SchiopuAndreiViorel/360-VideoBooth/Proiect 360VideoBooth/Imagini asamblare Finala/asamblare_5_vedere.jpeg

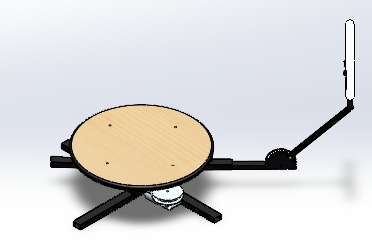
Proiect 360VideoBooth/Imagini asamblare Finala/asamblare_5_vedere.jpeg
