SchiopuAndreiViorel/360-VideoBooth/Proiect 360VideoBooth/SolidWorks/Untitled3.JPG

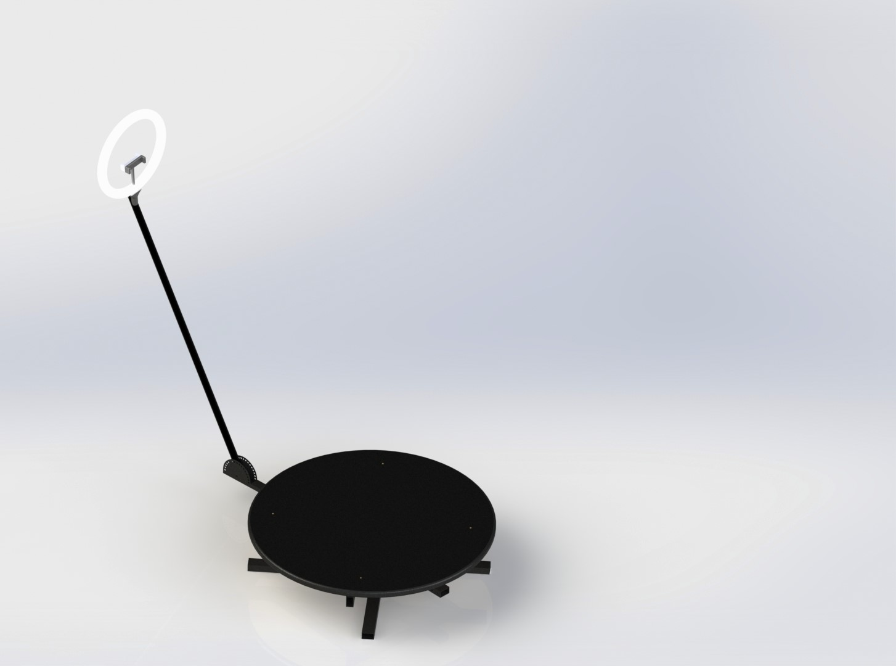
Proiect 360VideoBooth/SolidWorks/Untitled3.JPG
