SchiopuAndreiViorel/360-VideoBooth/Proiect 360VideoBooth/Simulare Cod+Parte electrica/link proiect thinkercad.txt

https://www.tinkercad.com/things/kW6MDn676y3-tinkercad-circuit-proiect
