SchiopuAndreiViorel/360-VideoBooth/Proiect 360VideoBooth/Imagini asamblare Finala/ansamblu_general.JPG

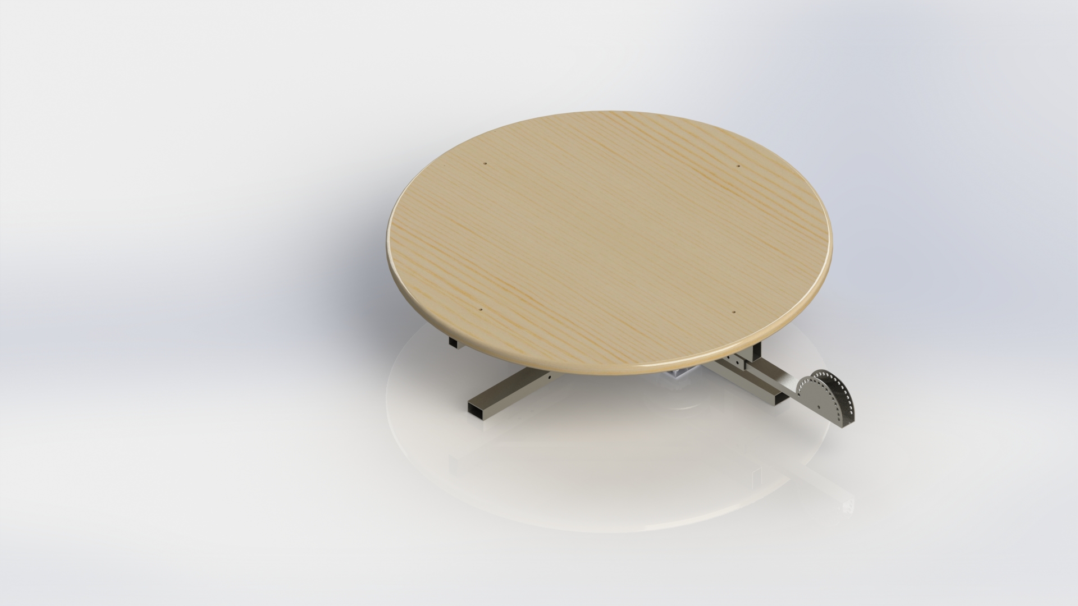
Proiect 360VideoBooth/Imagini asamblare Finala/ansamblu_general.JPG
