SchiopuAndreiViorel/360-VideoBooth/Proiect 360VideoBooth/Imagini asamblare Finala/DC-Motor.JPG

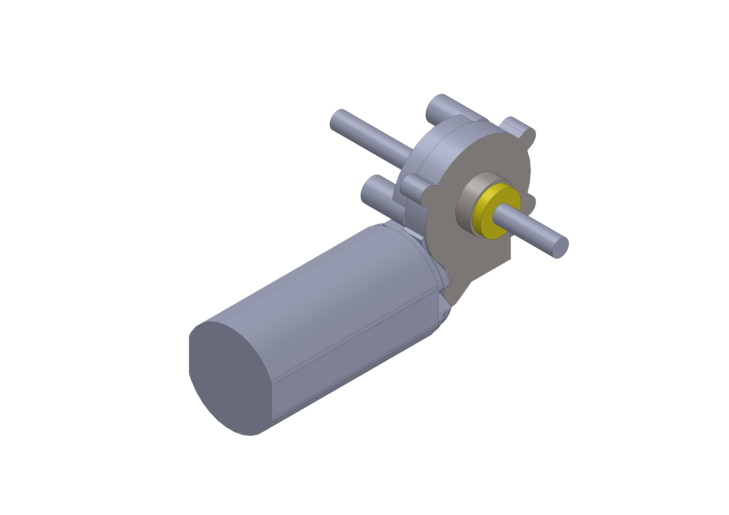
Proiect 360VideoBooth/Imagini asamblare Finala/DC-Motor.JPG
