SchiopuAndreiViorel/360-VideoBooth/Proiect 360VideoBooth/SolidWorks/Assem down - Copy.SLDASM

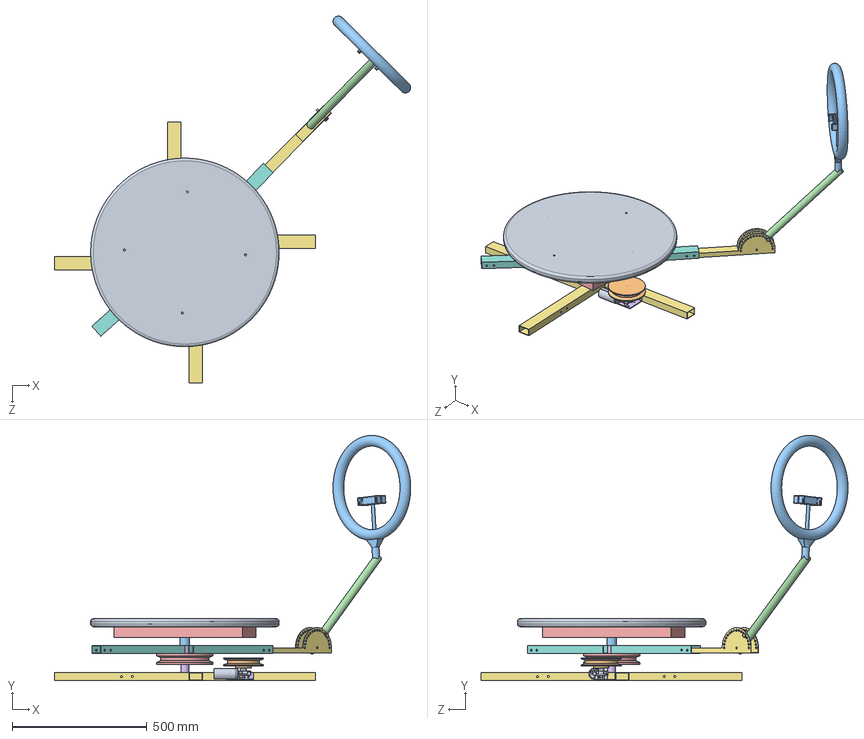
[picture p12: CAD file, 2026-05-26]
Proiect 360VideoBooth/SolidWorks/Assem down - Copy.SLDASM
1323.7 x 910.7 x 1362.8 mm
pulley
bearing x 2
pulley2
plate
holder 1 x 2
rod
ring light
siguranta
VALEO-NIDEC DC 24V Motor
