SchiopuAndreiViorel/360-VideoBooth/Proiect 360VideoBooth/SolidWorks/Assem top - Copy.SLDASM

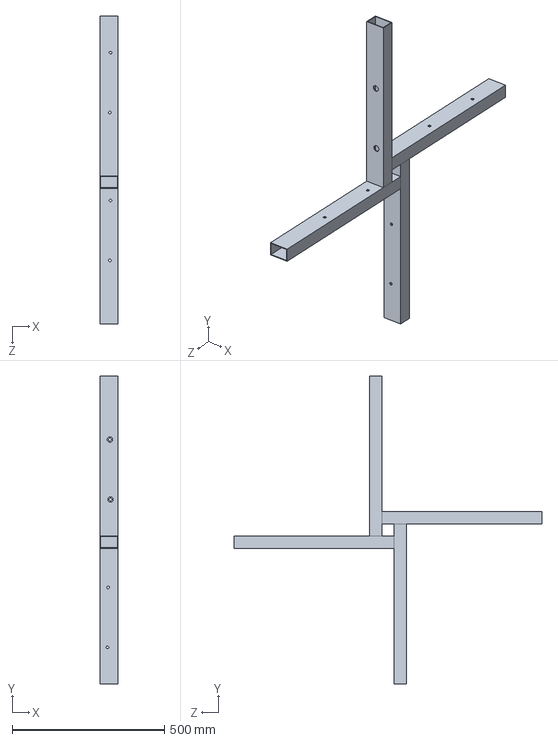
[picture p13: CAD file, 2026-05-26]
Proiect 360VideoBooth/SolidWorks/Assem top - Copy.SLDASM
60.0 x 1010.0 x 1010.0 mm
