SchiopuAndreiViorel/360-VideoBooth/Proiect 360VideoBooth/SolidWorks/holder 1.SLDPRT

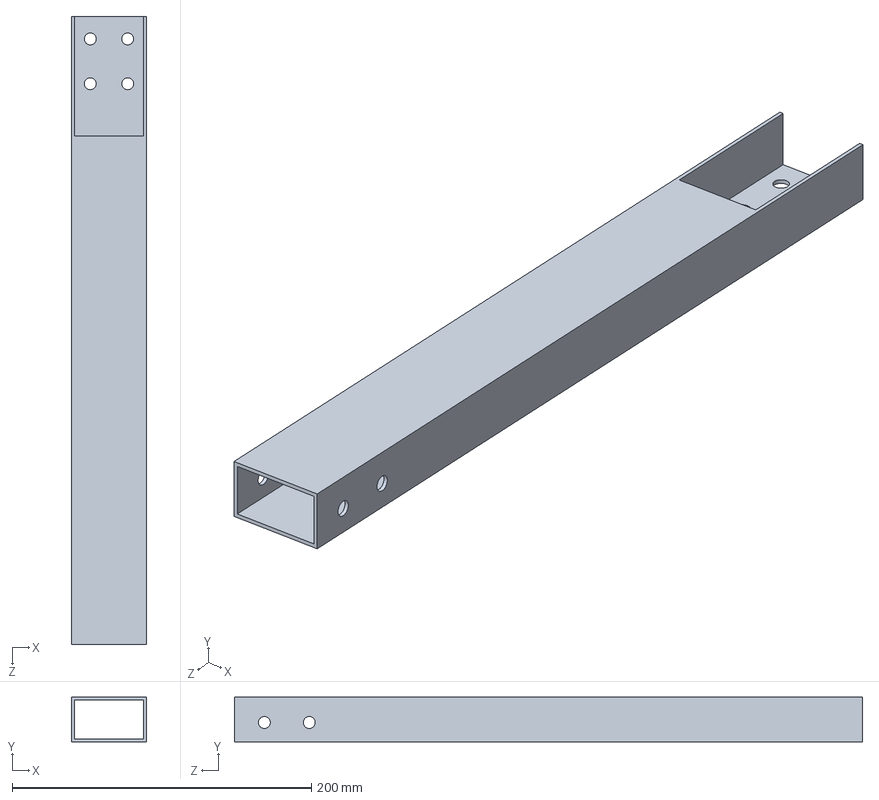
[picture p14: CAD file, 2026-05-26]
Proiect 360VideoBooth/SolidWorks/holder 1.SLDPRT
50.0 x 30.0 x 420.0 mm
