SchiopuAndreiViorel/360-VideoBooth/Proiect 360VideoBooth/SolidWorks/siguranta.SLDPRT

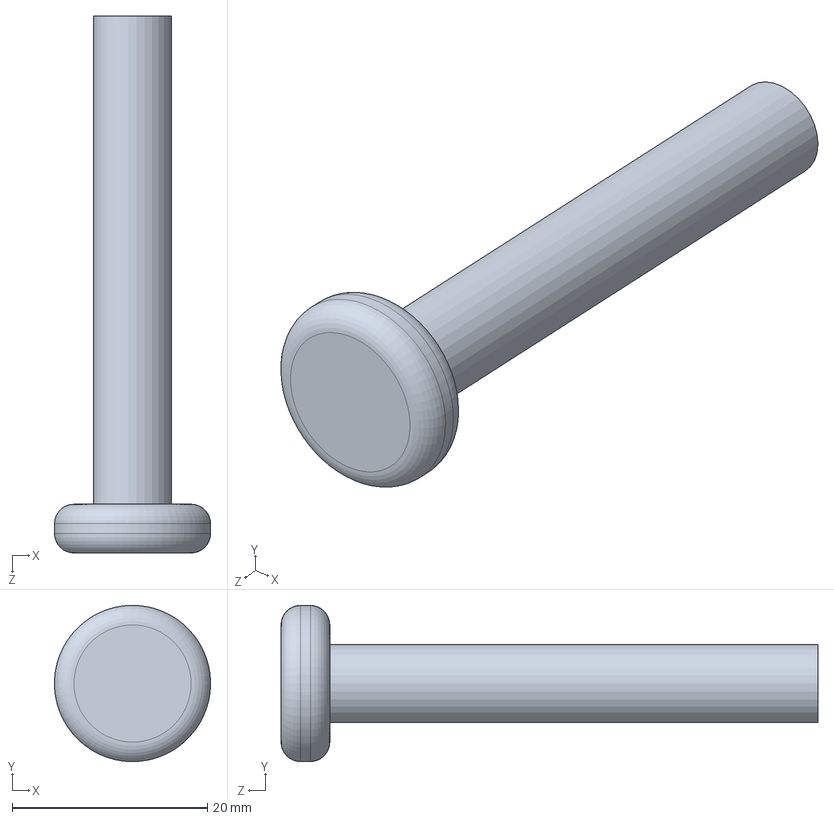
[picture p15: CAD file, 2026-05-26]
Proiect 360VideoBooth/SolidWorks/siguranta.SLDPRT
16.0 x 16.0 x 55.0 mm
