SchiopuAndreiViorel/360-VideoBooth/Proiect 360VideoBooth/SolidWorks/rod.SLDPRT

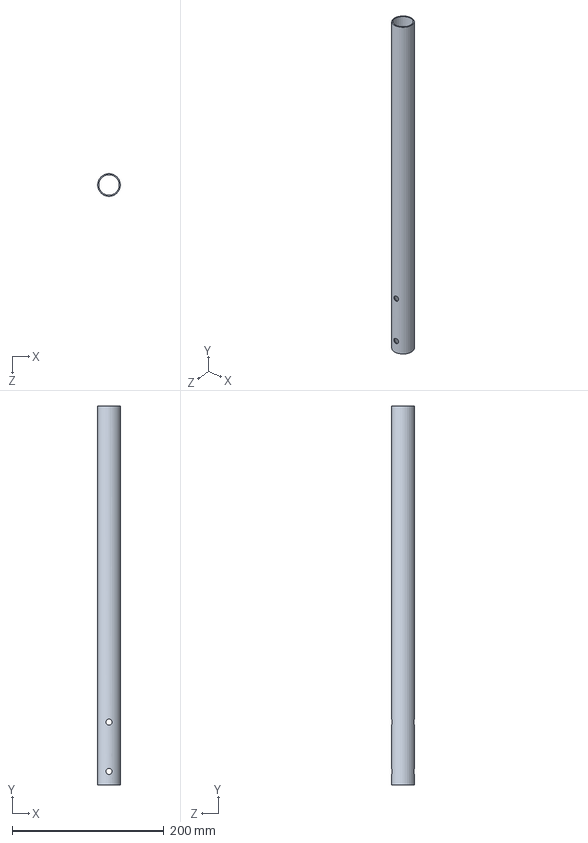
[picture p16: CAD file, 2026-05-26]
Proiect 360VideoBooth/SolidWorks/rod.SLDPRT
30.0 x 500.0 x 30.0 mm
