SchiopuAndreiViorel/360-VideoBooth/Proiect 360VideoBooth/SolidWorks/Part1.SLDPRT

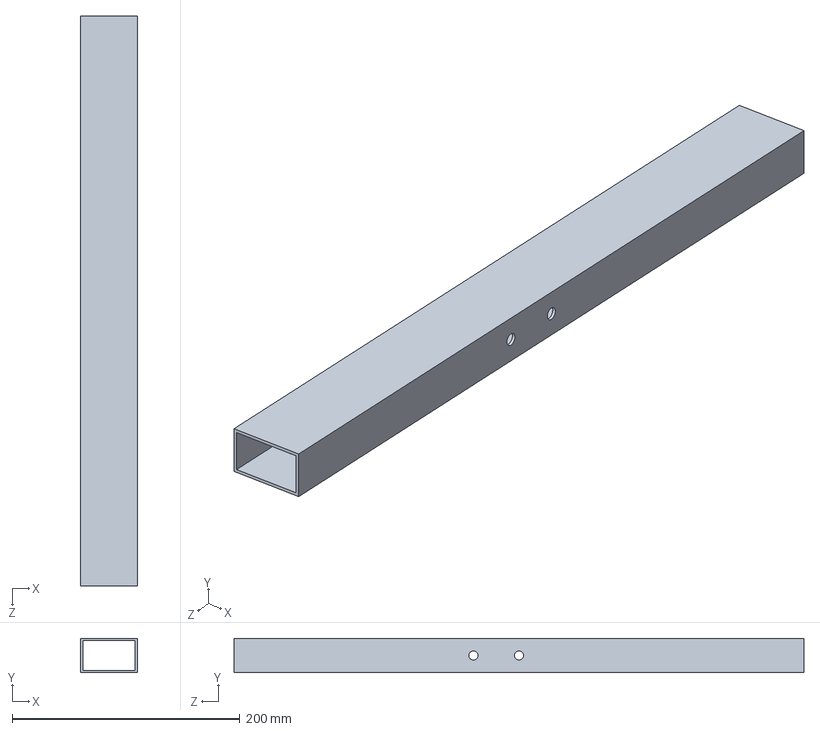
[picture p17: CAD file, 2026-05-26]
Proiect 360VideoBooth/SolidWorks/Part1.SLDPRT
50.0 x 30.0 x 500.0 mm
