SchiopuAndreiViorel/360-VideoBooth/Proiect 360VideoBooth/SolidWorks/Part5.SLDPRT

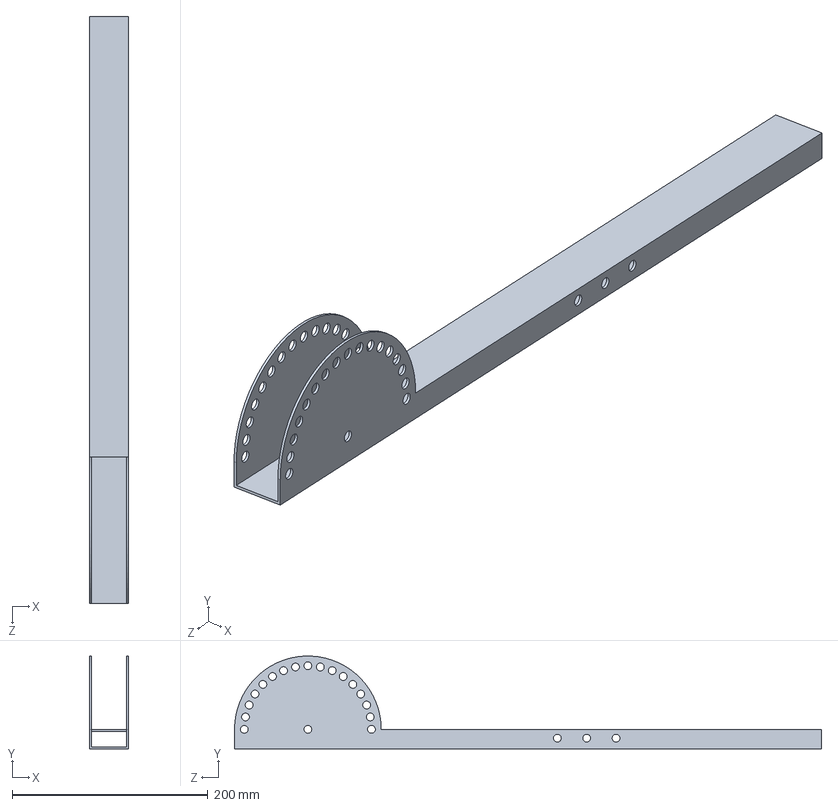
[picture p18: CAD file, 2026-05-26]
Proiect 360VideoBooth/SolidWorks/Part5.SLDPRT
40.0 x 94.9 x 600.0 mm
