SchiopuAndreiViorel/360-VideoBooth/Proiect 360VideoBooth/SolidWorks/pulley.SLDPRT

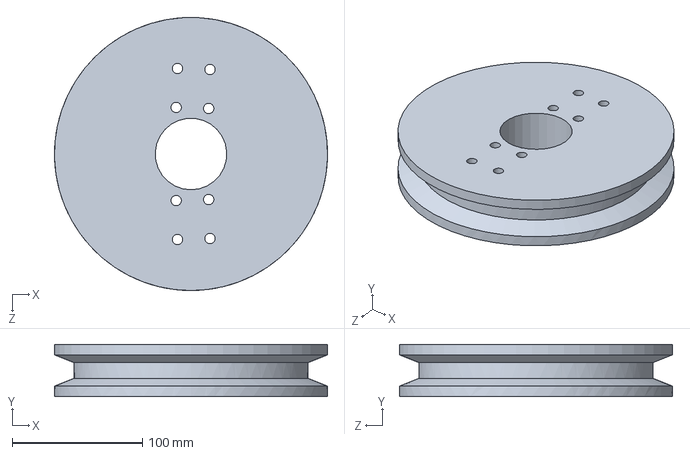
[picture p19: CAD file, 2026-05-26]
Proiect 360VideoBooth/SolidWorks/pulley.SLDPRT
209.9 x 40.0 x 210.0 mm
