SchiopuAndreiViorel/360-VideoBooth/Proiect 360VideoBooth/SolidWorks/Part7.SLDPRT

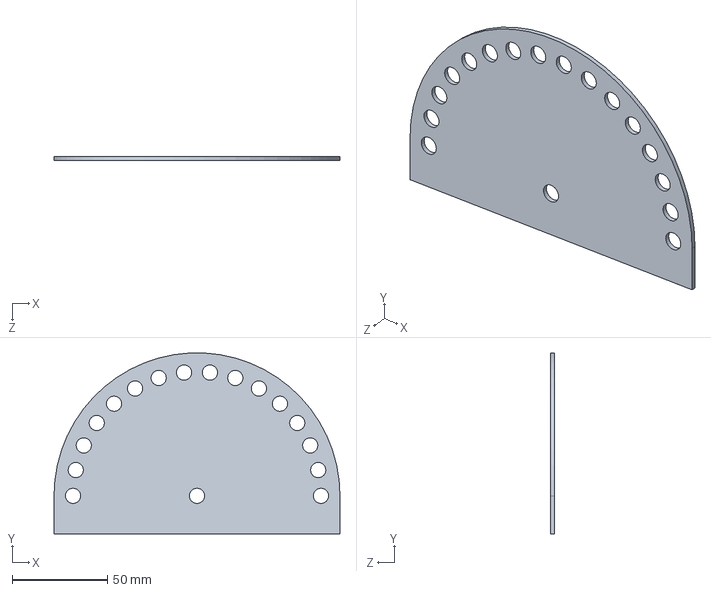
[picture p20: CAD file, 2026-05-26]
Proiect 360VideoBooth/SolidWorks/Part7.SLDPRT
150.0 x 94.9 x 2.00 mm
