SchiopuAndreiViorel/360-VideoBooth/Proiect 360VideoBooth/SolidWorks/Part2.SLDPRT

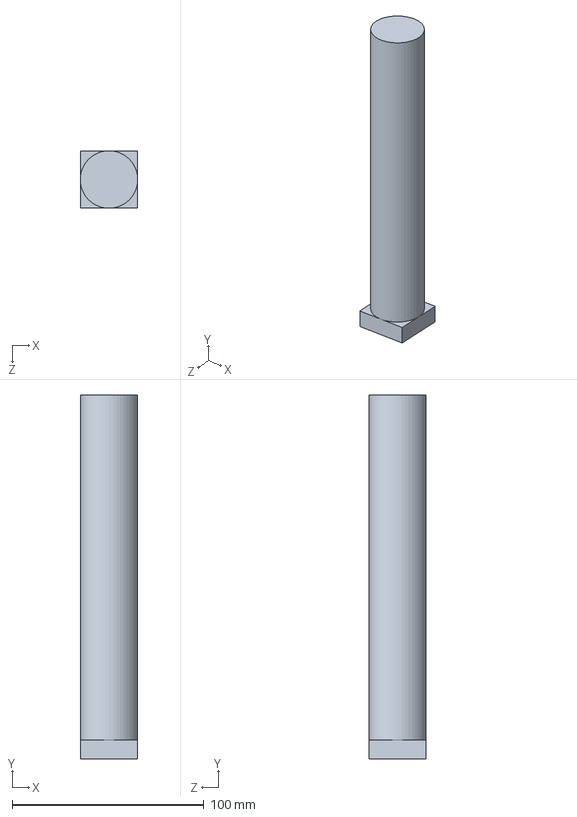
[picture p21: CAD file, 2026-05-26]
Proiect 360VideoBooth/SolidWorks/Part2.SLDPRT
30.0 x 190.0 x 30.0 mm
