SchiopuAndreiViorel/360-VideoBooth/Proiect 360VideoBooth/SolidWorks/pulley2.SLDPRT

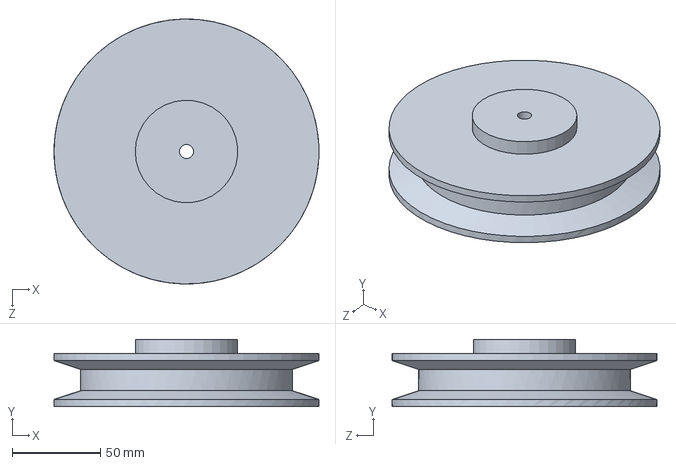
[picture p22: CAD file, 2026-05-26]
Proiect 360VideoBooth/SolidWorks/pulley2.SLDPRT
150.0 x 38.0 x 149.9 mm
