SchiopuAndreiViorel/360-VideoBooth/Proiect 360VideoBooth/SolidWorks/half circle.DXF

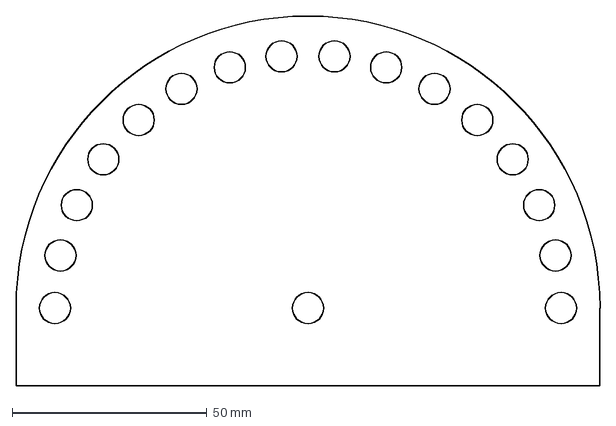
[picture p23: CAD file, 2026-05-26]
Proiect 360VideoBooth/SolidWorks/half circle.DXF
150.0 x 95.0 mm
