SchiopuAndreiViorel/360-VideoBooth/Proiect 360VideoBooth/SolidWorks/ring light.SLDPRT

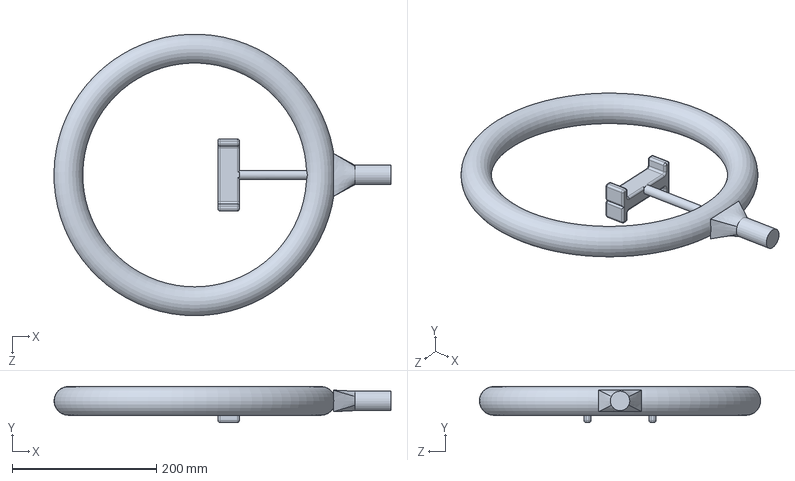
[picture p24: CAD file, 2026-05-26]
Proiect 360VideoBooth/SolidWorks/ring light.SLDPRT
467.0 x 50.0 x 389.8 mm
