SchiopuAndreiViorel/360-VideoBooth/Proiect 360VideoBooth/SolidWorks/Flat pattern - new.DXF

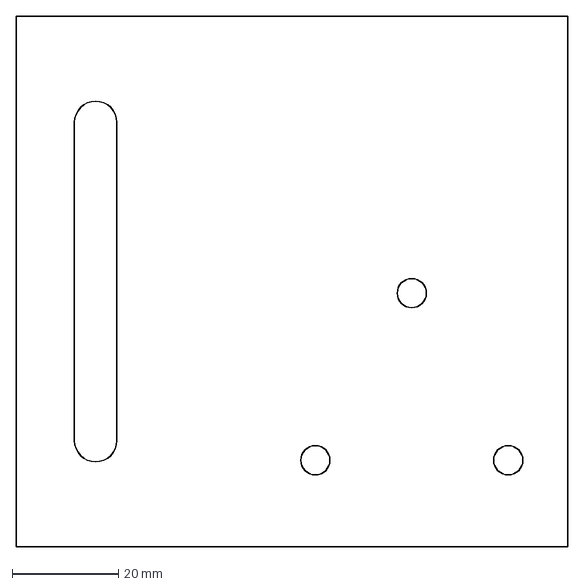
[picture p25: CAD file, 2026-05-26]
Proiect 360VideoBooth/SolidWorks/Flat pattern - new.DXF
104.0 x 100.0 mm
