SchiopuAndreiViorel/360-VideoBooth/Proiect 360VideoBooth/SolidWorks/plate.SLDPRT

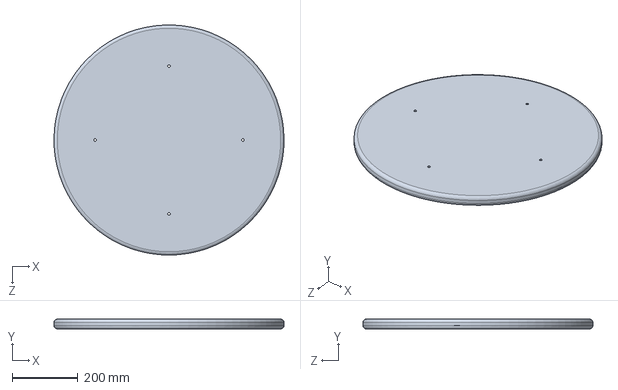
[picture p26: CAD file, 2026-05-26]
Proiect 360VideoBooth/SolidWorks/plate.SLDPRT
699.8 x 30.0 x 700.0 mm
