SchiopuAndreiViorel/360-VideoBooth/Proiect 360VideoBooth/SolidWorks/Part11.SLDPRT

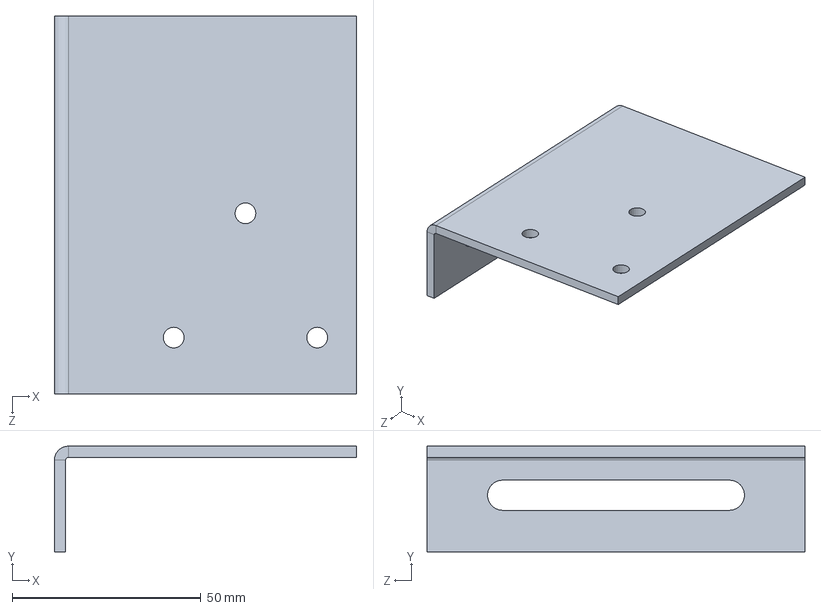
[picture p27: CAD file, 2026-05-26]
Proiect 360VideoBooth/SolidWorks/Part11.SLDPRT
80.0 x 28.0 x 100.0 mm
