SchiopuAndreiViorel/360-VideoBooth/Proiect 360VideoBooth/SolidWorks/Part4.SLDPRT

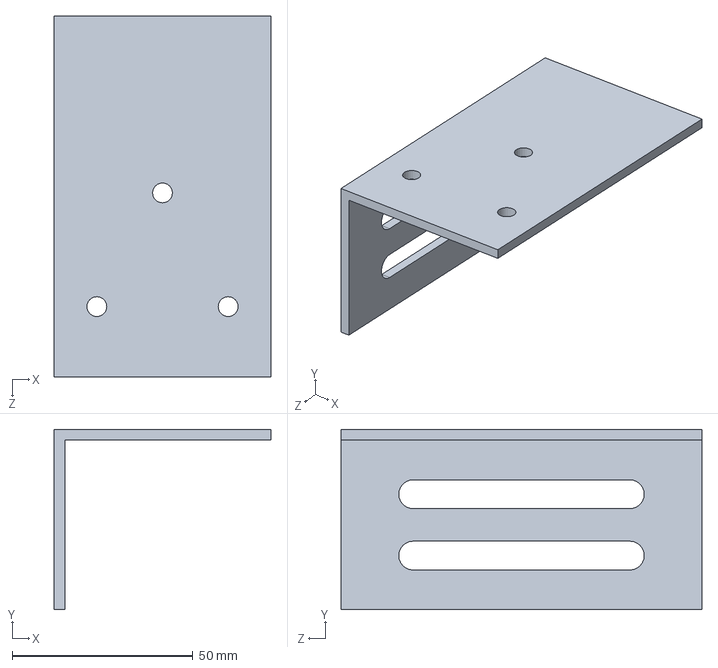
[picture p28: CAD file, 2026-05-26]
Proiect 360VideoBooth/SolidWorks/Part4.SLDPRT
60.0 x 50.0 x 100.0 mm
