SchiopuAndreiViorel/360-VideoBooth/Proiect 360VideoBooth/SolidWorks/bearing.SLDPRT

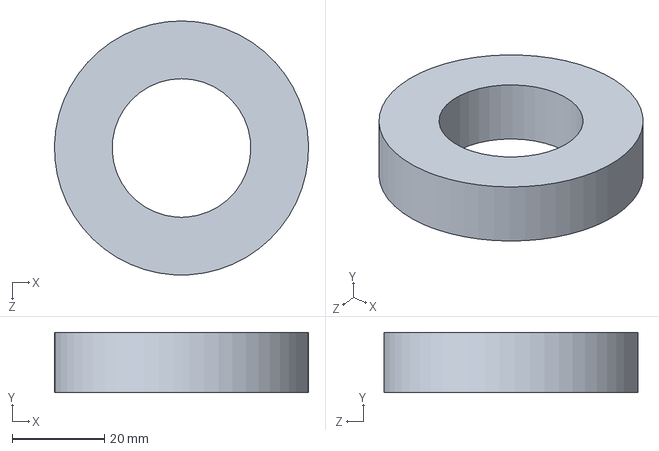
[picture p29: CAD file, 2026-05-26]
Proiect 360VideoBooth/SolidWorks/bearing.SLDPRT
55.0 x 13.0 x 55.0 mm
