SchiopuAndreiViorel/360-VideoBooth/Proiect 360VideoBooth/SolidWorks/Part3.SLDPRT

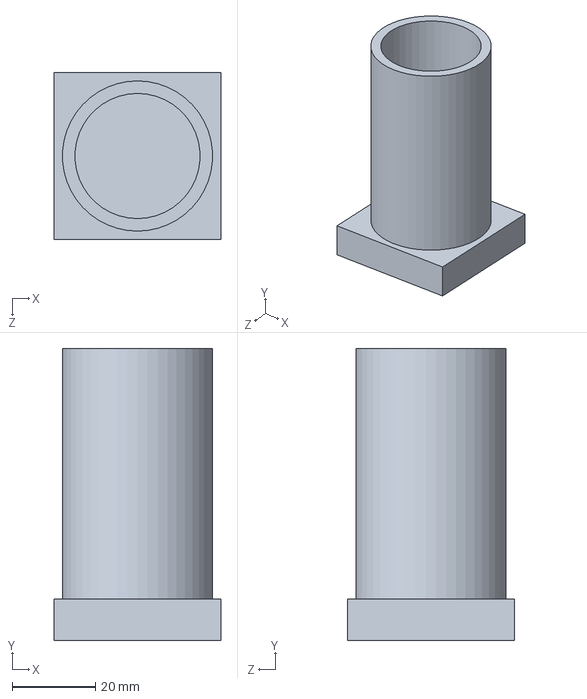
[picture p30: CAD file, 2026-05-26]
Proiect 360VideoBooth/SolidWorks/Part3.SLDPRT
40.0 x 70.0 x 40.0 mm
