SchiopuAndreiViorel/360-VideoBooth/Proiect 360VideoBooth/SolidWorks/VALEO-NIDEC DC 24V Motor.SLDPRT

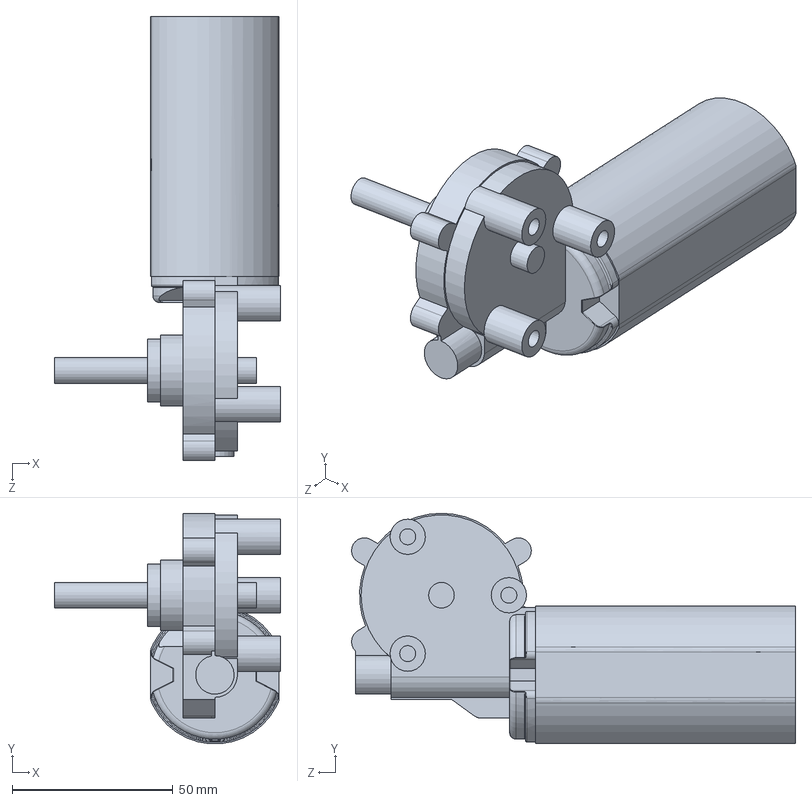
[picture p31: CAD file, 2026-05-26]
Proiect 360VideoBooth/SolidWorks/VALEO-NIDEC DC 24V Motor.SLDPRT
70.5 x 71.7 x 138.2 mm
