SchiopuAndreiViorel/360-VideoBooth/Proiect 360VideoBooth/SolidWorks/Part1.2.SLDPRT

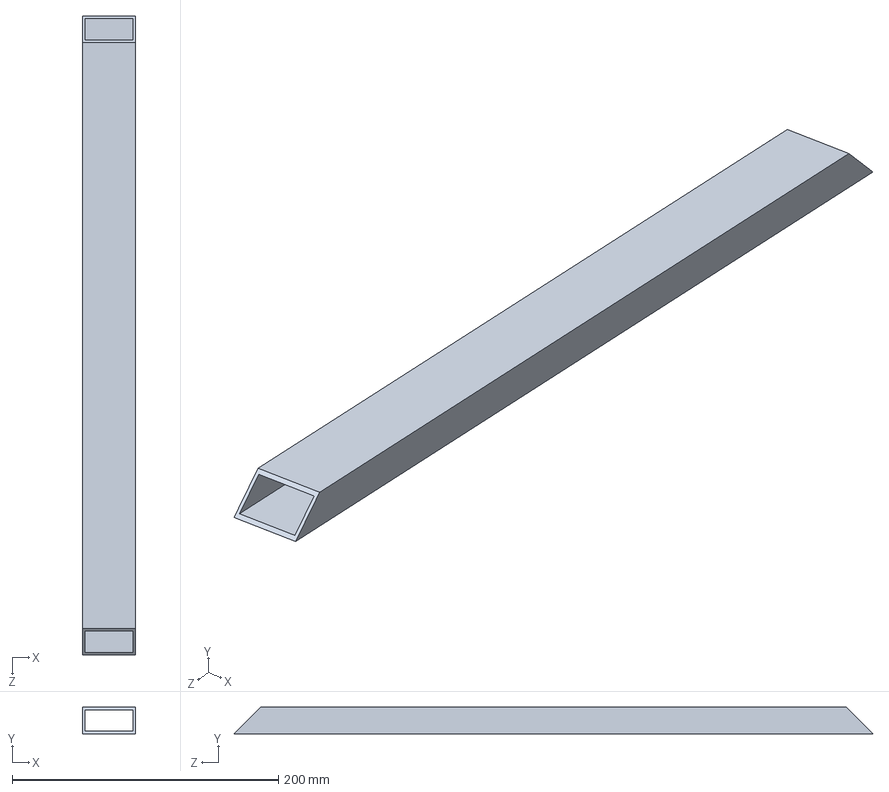
[picture p32: CAD file, 2026-05-26]
Proiect 360VideoBooth/SolidWorks/Part1.2.SLDPRT
40.0 x 20.0 x 480.0 mm
