SchiopuAndreiViorel/360-VideoBooth/(list of files, cad)

Other CAD files:
Proiect 360VideoBooth/SolidWorks/Assem down - Copy.SLDDRW
Proiect 360VideoBooth/SolidWorks/Assem down2 - Copy.SLDDRW
Proiect 360VideoBooth/SolidWorks/Assem down3 - Copy.SLDDRW
Proiect 360VideoBooth/SolidWorks/Assem top - Copy.SLDDRW
Proiect 360VideoBooth/SolidWorks/Assem top2 - Copy.SLDDRW
Proiect 360VideoBooth/SolidWorks/Assem topp - Copy.SLDDRW
Proiect 360VideoBooth/SolidWorks/Assem up - Copy.SLDDRW
Proiect 360VideoBooth/SolidWorks/holder 1.SLDDRW
